domergan/drsstc/sources/universal_driver_pic_top.jpg

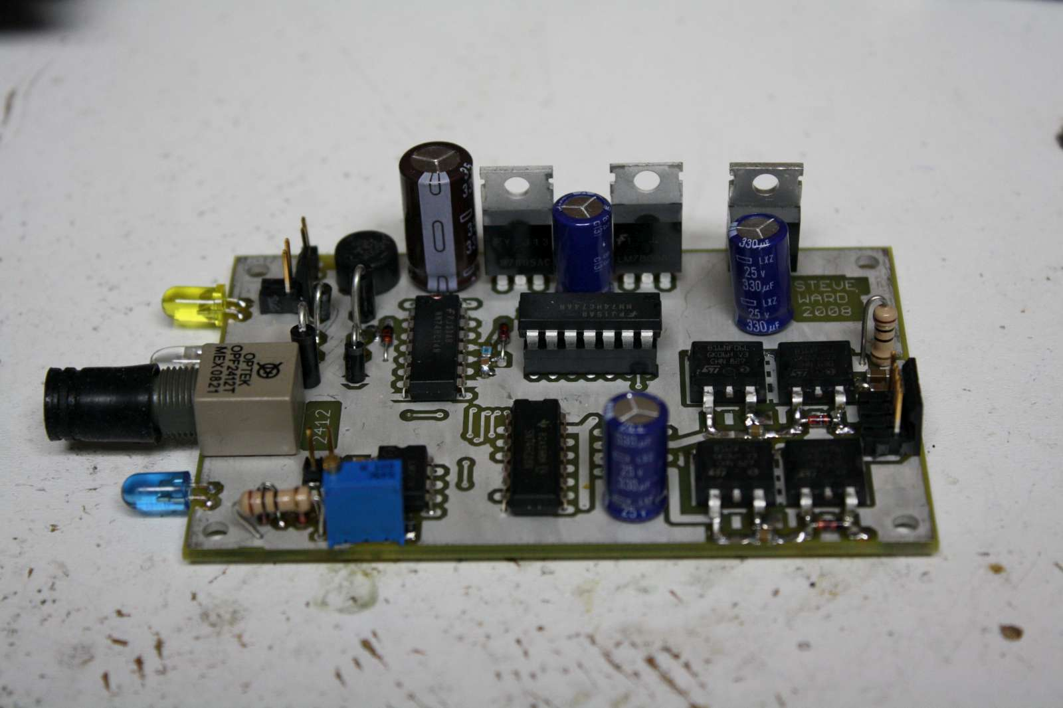
sources/universal_driver_pic_top.jpg
