domergan/drsstc/sources/universal_driver_pic_bottom.jpg

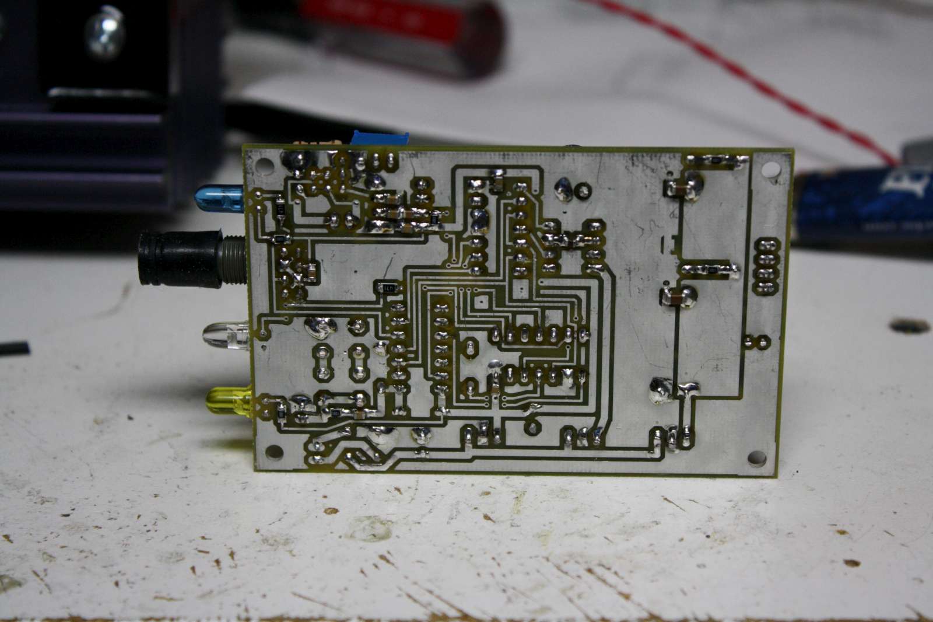
sources/universal_driver_pic_bottom.jpg
