domergan/drsstc/README.md

# Dual Resonance SSTC

My repo containing all my files and codes for my DRSSTC project. 

## Sources

- https://www.stevehv.4hv.org/DRSSTC.5.htm
- https://www.stevehv.4hv.org/new_driver.html
- https://www.f-legrand.fr/scidoc/docmml/sciphys/arduino/onduleur2/onduleur2.html
