domergan/drsstc/sources/DRSSTC-.5sch.JPG

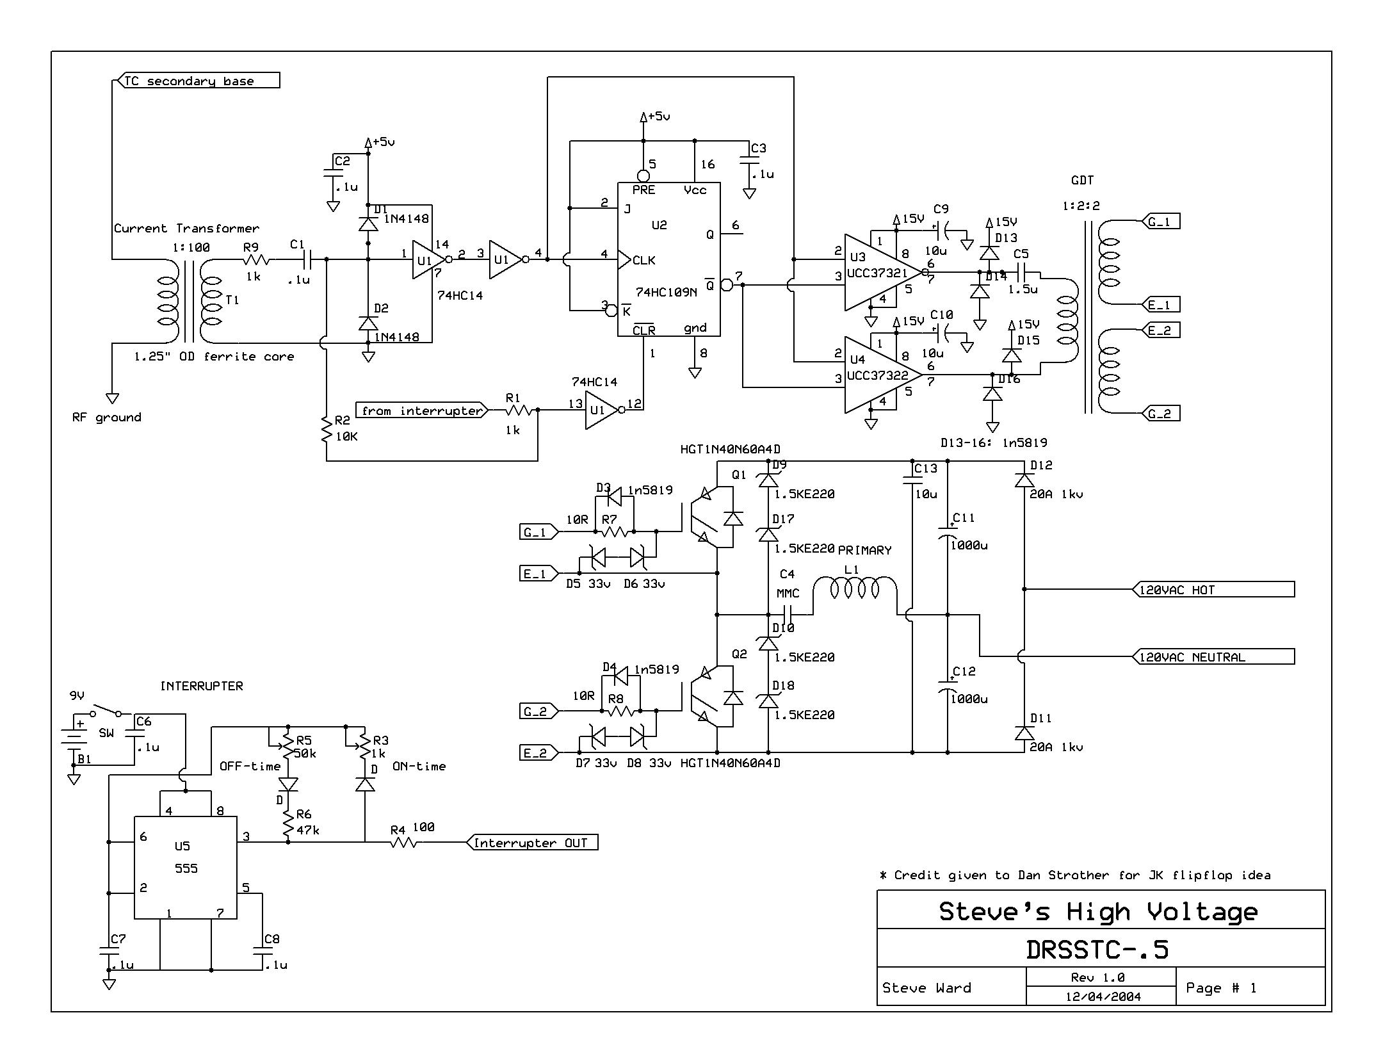
sources/DRSSTC-.5sch.JPG
