domergan/drsstc/kicad/BOM.ods

Part Description | Part number (OLD) | schematic ID (OLD) | Part Number (NEW) | Schematic ID (NEW) | Quantity | Comment | Supplier Link (LCSC, Digikey)
74HC14 Schmitt Trigger | MM74HC14N | IC1 | MM74HC14M | U1 | 1 |  | https://www.lcsc.com/product-detail/C900094.html?s_z=n_q_p_MM74HC14N
74HC74 D Flip-Flop | MM74HC74AN | IC3 | SN74HC74DR | U7 | 1 |  | https://www.lcsc.com/product-detail/C6762.html?s_z=n_q_t_74HC74
74HC08 AND Gate | SN74HC08N | IC2 | SN74HC08DR | U6 | 1 |  | https://www.lcsc.com/product-detail/C337768.html?s_z=n_q_t_74HC08
LM311 Differential Comparator | LM311N | IC4 | LM311MX/NOPB | U5 | 1 |  | https://www.lcsc.com/product-detail/C7939.html?s_z=n_q_t_LM311M
UCC27423 Gate Driver | UCC27423P | IC8 | UCC27523D | U2 | 1 |  | https://www.lcsc.com/product-detail/C206023.html?s_z=n_q_UCC27523
7805 Regulator | L7805ACV | IC7 | L7805ACV-DG | U8 | 1 |  | https://www.lcsc.com/product-detail/C472632.html?s_z=n_q_L7805ACV
7809 Regulator | L7809ACV | IC6 | L7809CV-DG | U3 | 1 |  | https://www.lcsc.com/product-detail/C3794.html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
7824 Regulator | L7824ACV | IC5 | L7824CV | U10 | 1 |  | https://www.lcsc.com/product-detail/C262910.html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
STB16NF06 nFET | STB16NF06L | Q1,Q2 | / | / | 2 | OBSOLETE
STB16PF06 pFET | STB16PF06L | Q3,Q4 | / | / | 2 | OBSOLETE
nFET-pFET Pair | / | / | FDS4559 | Q1, Q2 |  | REPLACEMENT | https://www.lcsc.com/product-detail/C97044.html?s_z=n_q_x_FDS4559
10uF 50V 1206 X7R | 81-GRM31CF51E106ZA01 | C11,C12,C13,C14 | CL31B106KBHNNNE | C3, C4, C7, C21 | 4 |  | https://www.lcsc.com/product-detail/C89632.html
1uF 50V 1206 X7R | 80-C0805C105Z4V | C8 | CL31B105KBHNNNE | C10, C11, C16, C17, C18 | 1 |  | https://www.lcsc.com/product-detail/C1848.html
100nF 50V 0805 X7R | VJ0805Y104KXAAT | C1,C2,C5,C7,C9,C10,C19,C20,C22 | CL21B104KBCNNNC | C1, C5, C20, C8, C9 | 9 |  | https://www.lcsc.com/product-detail/C1711.html
22nF 0805 | 80-C0805C223K1R | C3 | / | C6 | 1 | Kit
1nF 0805 | C0805C102K5RAC7411 | C4,C6 | / | C2, C19 | 2 | Kit
100uF 35V lytic 20 % | 647-UPJ1V101MPD | C15 | UES1V101MPM | C12 | 1 |  | https://www.lcsc.com/product-detail/C1668995.html
330uF 35V lytic 20 % | 661-ELXZ250ELL331MH1 | C16,C17,C18 | UKA1V331MPD1TD | C13, C14, C15 | 3 |  | https://www.lcsc.com/product-detail/C1585271.html
100V 2A bridge | 625-W01G-E4 | B1 | TB210S | D14 | 1 |  | https://www.lcsc.com/product-detail/C4749007.html
4.7V 5W zener | 1N5337B | D3,D4 | 1N5337BRLG | D18, D19 | 2 |  | https://www.lcsc.com/product-detail/C9705.html?s_z=n_q_1N5337B
1n5819 schottky | 1N5819 | D1,D2,D8,D9,D10,D11 | 1N5819 | D1, D4, D7, D8, D9, D10 | 6 |  | https://www.lcsc.com/product-detail/C110032.html?s_z=n_q_l_1N5819
1n4148 diode | 1N4148 | D5,D6,D7 | 1N4148TR | D5, D6, D12 | 3 |  | https://www.lcsc.com/product-detail/C84410.html?s_z=n_q_t_1N4148
10k trimpot | 72-T93YA-10K | R3 | / | RV1 | 1 | Kit
1k 0805 | 292-1.0K-RC | R1,R6,R7,R9,R10,R12 | / | R9, R3, R6, R7, R1, R11, R12 | 6 | Kit
475R 0805 | 260-475-RC | R8,R13 | / | R4, R13 | 2 | Kit
2k2 SMD (1k in the schematic…) | 292-2.2K-RC | R14 | / | / | 1
20k 0805 SMD | 292-20k-RC | R2 | / | R5 | 1 | Kit
10R 500mW 1 % | 660-CF1/2CT52R100J | R4,R11 | CRM1206-FX-10R0ELF | R2, R10 | 2 |  | https://www.lcsc.com/product-detail/C840609.html
Green LED | ? | D16 | TLHG4200 | D16, D17 | 1 |  | https://www.lcsc.com/product-detail/C6333075.html?s_z=n_q_t_LED
blue LED | 638-264-7SUBCC4704 | D18 | / | / | 1
red LED (Not used) | ? | D13 | / | D11 | 1 | Kit
Fiber optic Rx (Not used) | OPF2412T | XR1 | / | / | 1
Screw Terminal | 22-28-0360 | JP1, JP2, JP3, JP4,JP5,JP6 | / | JP1, JP2, JP3, JP4,JP5,JP6 | 1 | Kit
NOT ON BOARD BUT MAY BE REQUIRED FOR CIRCUIT
18V 1A xfrmr | LP433 | powers board |  |  | 3,1
ferrite toroids ** | G6683 | used for current sense |  |  | 0,99
Stand-offs 4-40 x 0.5" | ? | mechanical board support
GDT toroid 5000 mat. | 32-29-22-0002 | used for LARGE GDT | 5977001021 | / | 1 |  | https://www.digikey.be/en/products/detail/fair-rite-products-corp/5977001021/15930548
aluminum project box | 270-238 |  |  |  | 1
PARTS LIST FOR DRSSTC CONTROLLER REVISIONS 1.2/1.3 ONLY!
**A similar sized 5000 material toroid from TSC ferrite would work fine
