domergan/drsstc/3d_parts/STEP/assembly_reference.step

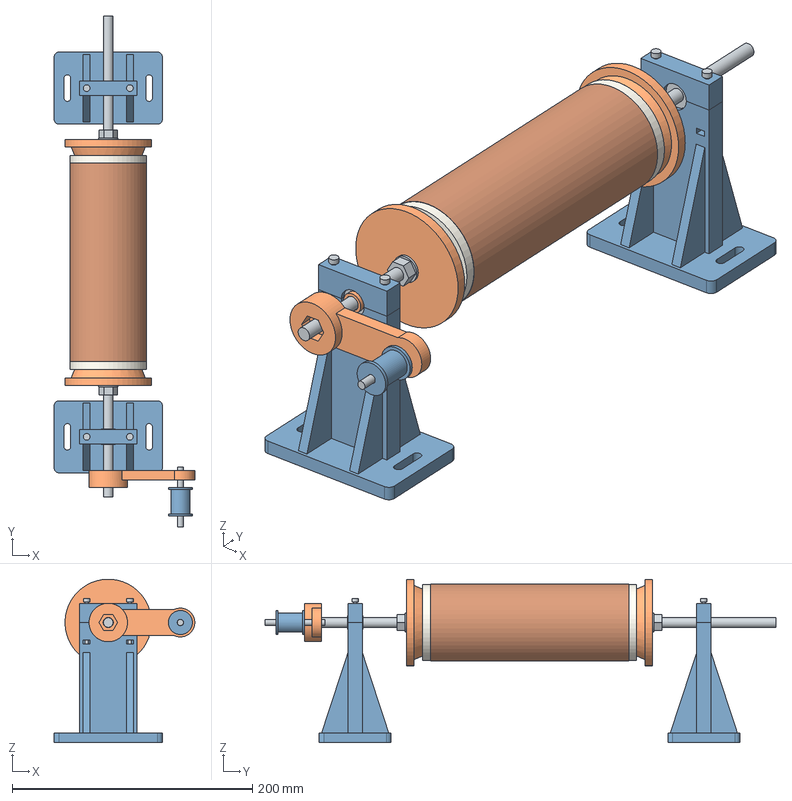
[picture p4: CAD file, 2026-09-12]
3d_parts/STEP/assembly_reference.step
117.0 x 425.0 x 136.0 mm
stand_1
cap_1
bearing_608_1
cap_screw_0_0
cap_screw_0_1
stand_2
cap_2
bearing_608_2
cap_screw_1_0
cap_screw_1_1
M8_threaded_rod_400mm
chuck_1
chuck_captive_nut_0
chuck_back_nut_0
chuck_washer_0
chuck_2
chuck_captive_nut_1
chuck_back_nut_1
chuck_washer_1
PVC_form_illustrative_ID56mm
wire_envelope_reference_only
hand_crank
rotating_grip
M5_handle_bolt
locating_bearing_spacer_0
locating_bearing_spacer_1
