domergan/drsstc/3d_parts/STEP/fit_coupon.step

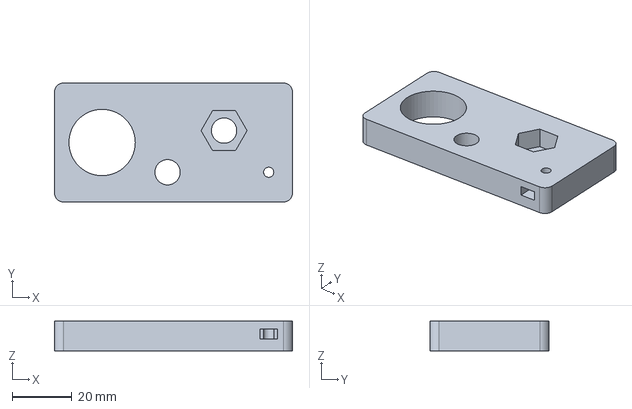
[picture p5: CAD file, 2026-09-12]
3d_parts/STEP/fit_coupon.step
80.0 x 40.0 x 10.0 mm
