domergan/drsstc/3d_parts/winder_parts.3mf

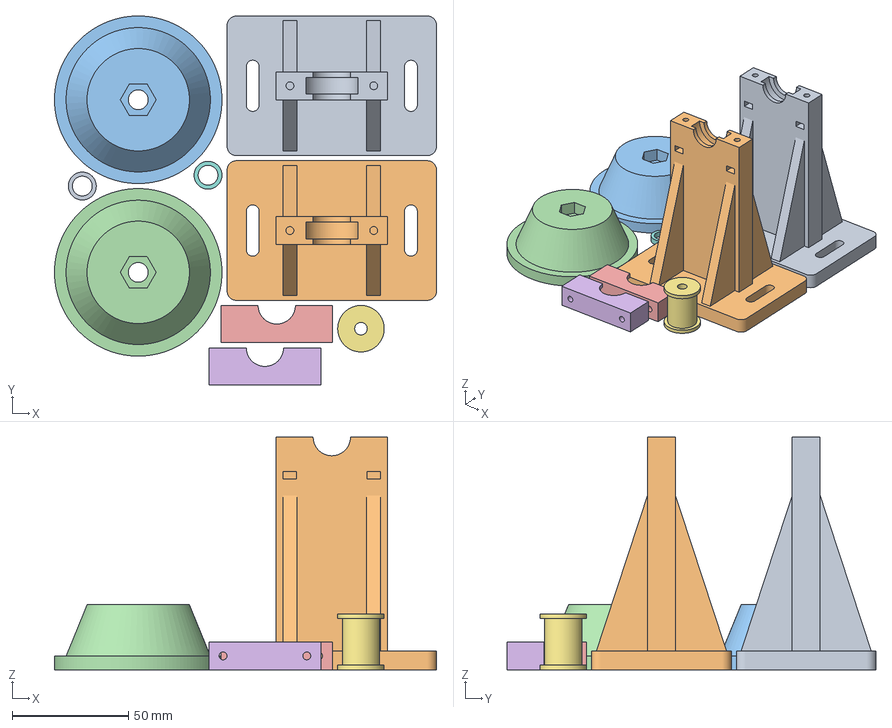
[picture p6: CAD file, 2026-09-12]
3d_parts/winder_parts.3mf
164.2 x 158.6 x 100.0 mm
stand_1
stand_2
centering_chuck_3
centering_chuck_4
bearing_cap_6
bearing_cap_7
rotating_grip_8
bearing_spacer_9
bearing_spacer_10
