domergan/drsstc/3d_parts/STEP/centering_chuck.step

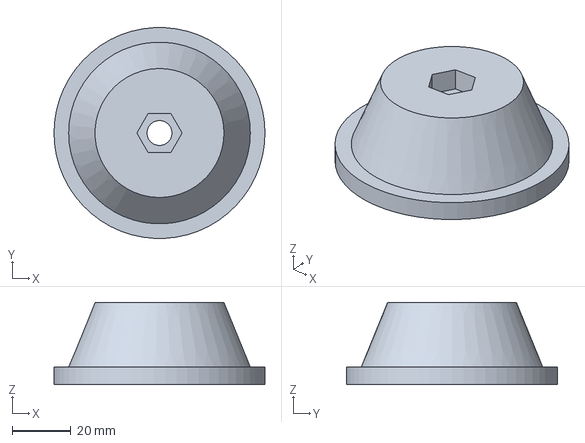
[picture p7: CAD file, 2026-09-12]
3d_parts/STEP/centering_chuck.step
72.0 x 71.9 x 28.0 mm
