domergan/drsstc/3d_parts/STEP/bearing_spacer.step

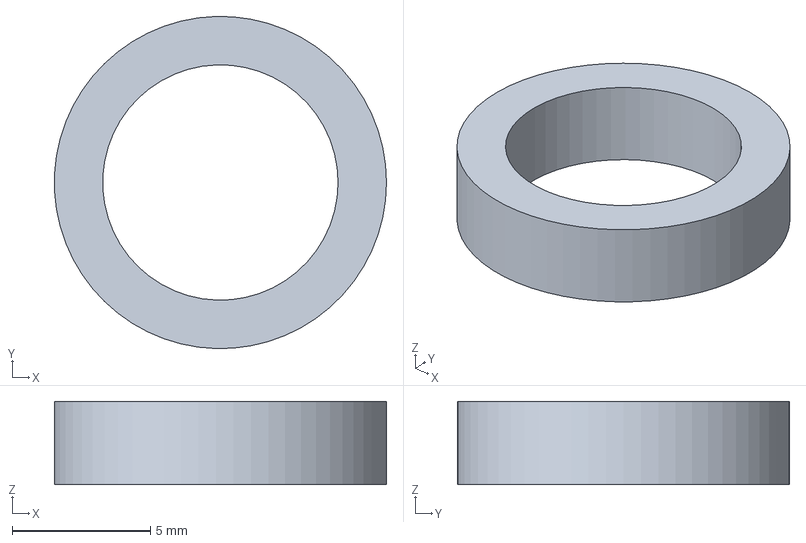
[picture p8: CAD file, 2026-09-12]
3d_parts/STEP/bearing_spacer.step
12.0 x 12.0 x 3.00 mm
