domergan/drsstc/3d_parts/STEP/hand_crank.step

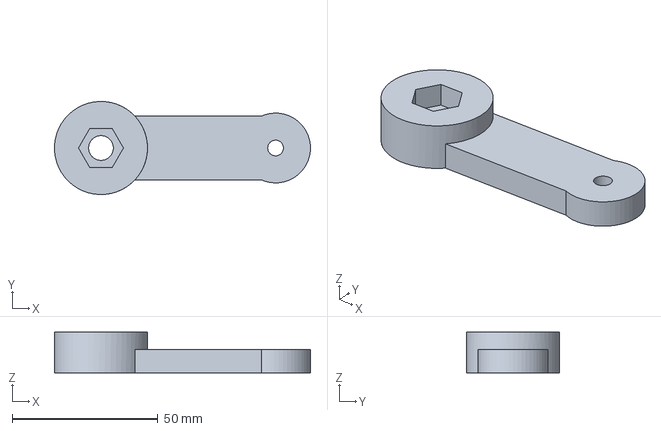
[picture p9: CAD file, 2026-09-12]
3d_parts/STEP/hand_crank.step
88.0 x 32.0 x 14.0 mm
