domergan/drsstc/3d_parts/STEP/stand.step

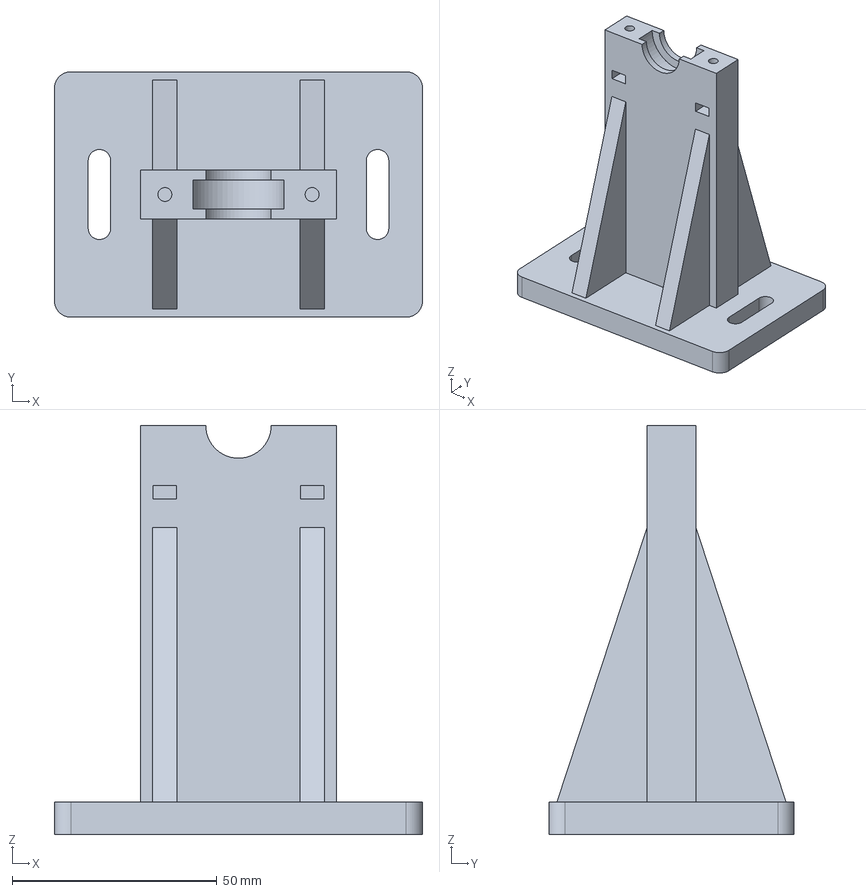
[picture p10: CAD file, 2026-09-12]
3d_parts/STEP/stand.step
90.0 x 60.0 x 100.0 mm
