domergan/drsstc/3d_parts/STEP/bearing_cap.step

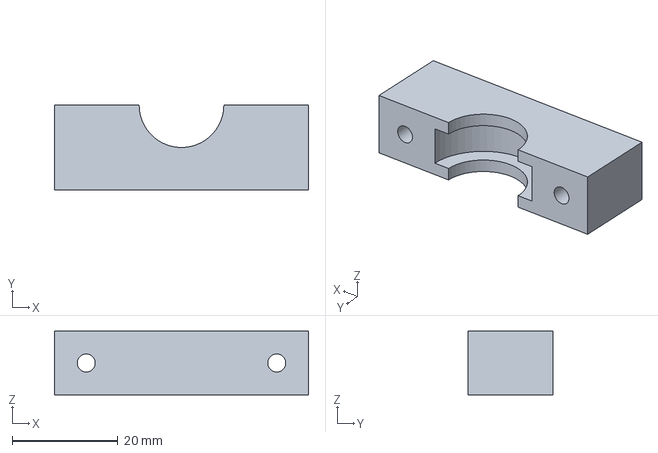
[picture p11: CAD file, 2026-09-12]
3d_parts/STEP/bearing_cap.step
48.0 x 16.0 x 12.0 mm
