domergan/drsstc/3d_parts/STEP/rotating_grip.step

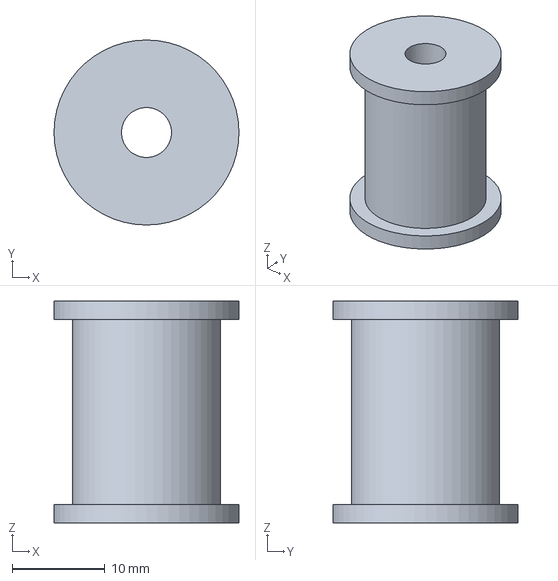
[picture p12: CAD file, 2026-09-12]
3d_parts/STEP/rotating_grip.step
20.0 x 20.0 x 24.0 mm
