domergan/drsstc/(list of files, cad)

Other CAD files:
3d_parts/STL/bearing_cap.stl
3d_parts/STL/bearing_spacer.stl
3d_parts/STL/centering_chuck.stl
3d_parts/STL/fit_coupon.stl
3d_parts/STL/hand_crank.stl
3d_parts/STL/rotating_grip.stl
3d_parts/STL/stand.stl
