domergan/drsstc/sources/DRSSTC_pndriver1_3_bcomp.pdf

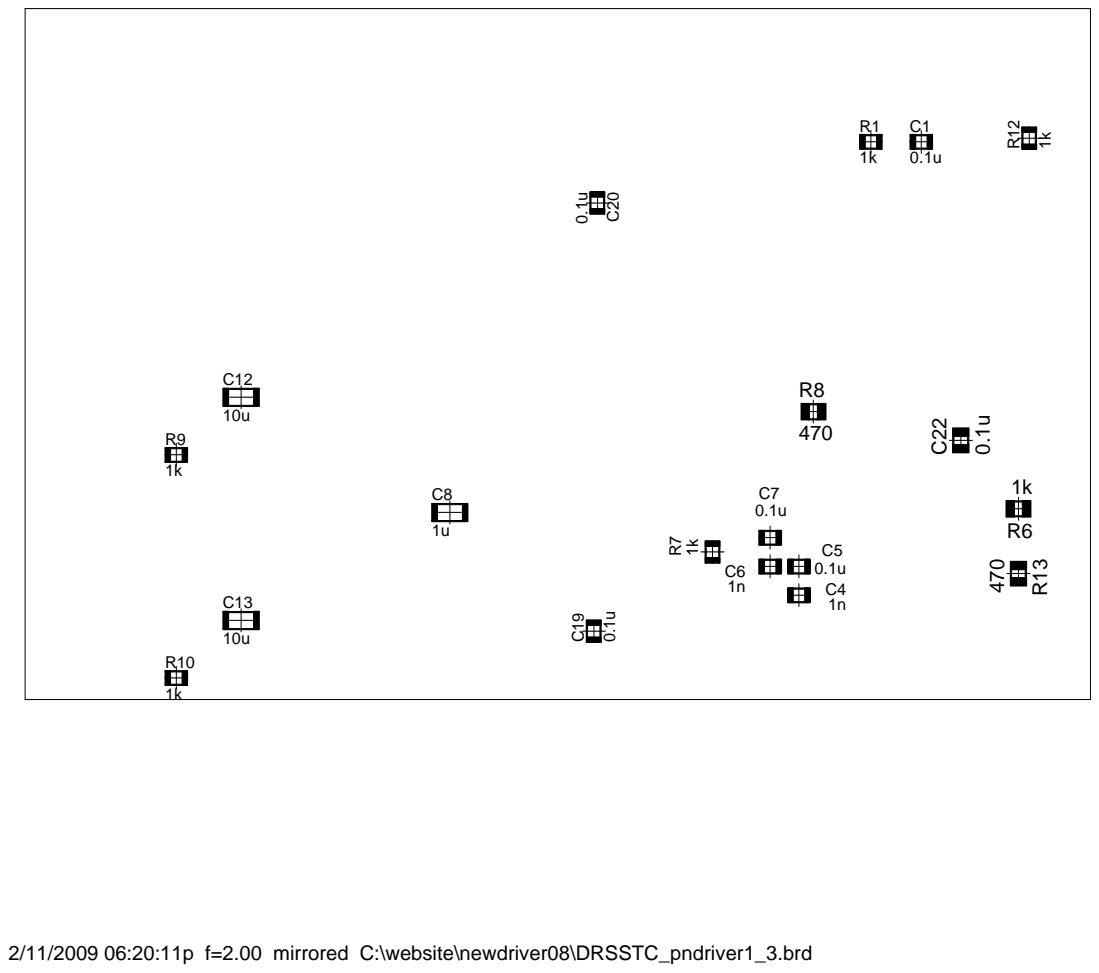
[picture p13: page 1]
