domergan/drsstc/sources/DRSSTC_pndriver1_3_tcomp.pdf

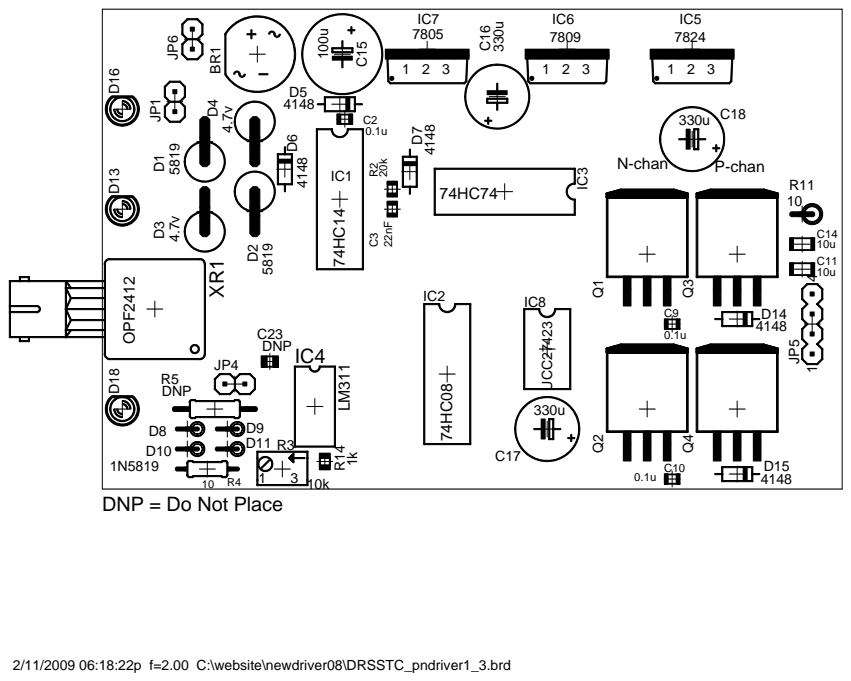
[picture p14: page 1]
