domergan/drsstc/kicad/controller/controller.kicad_pcb

## KiCad design kicad/controller/controller.kicad_pcb (2026-09-12)

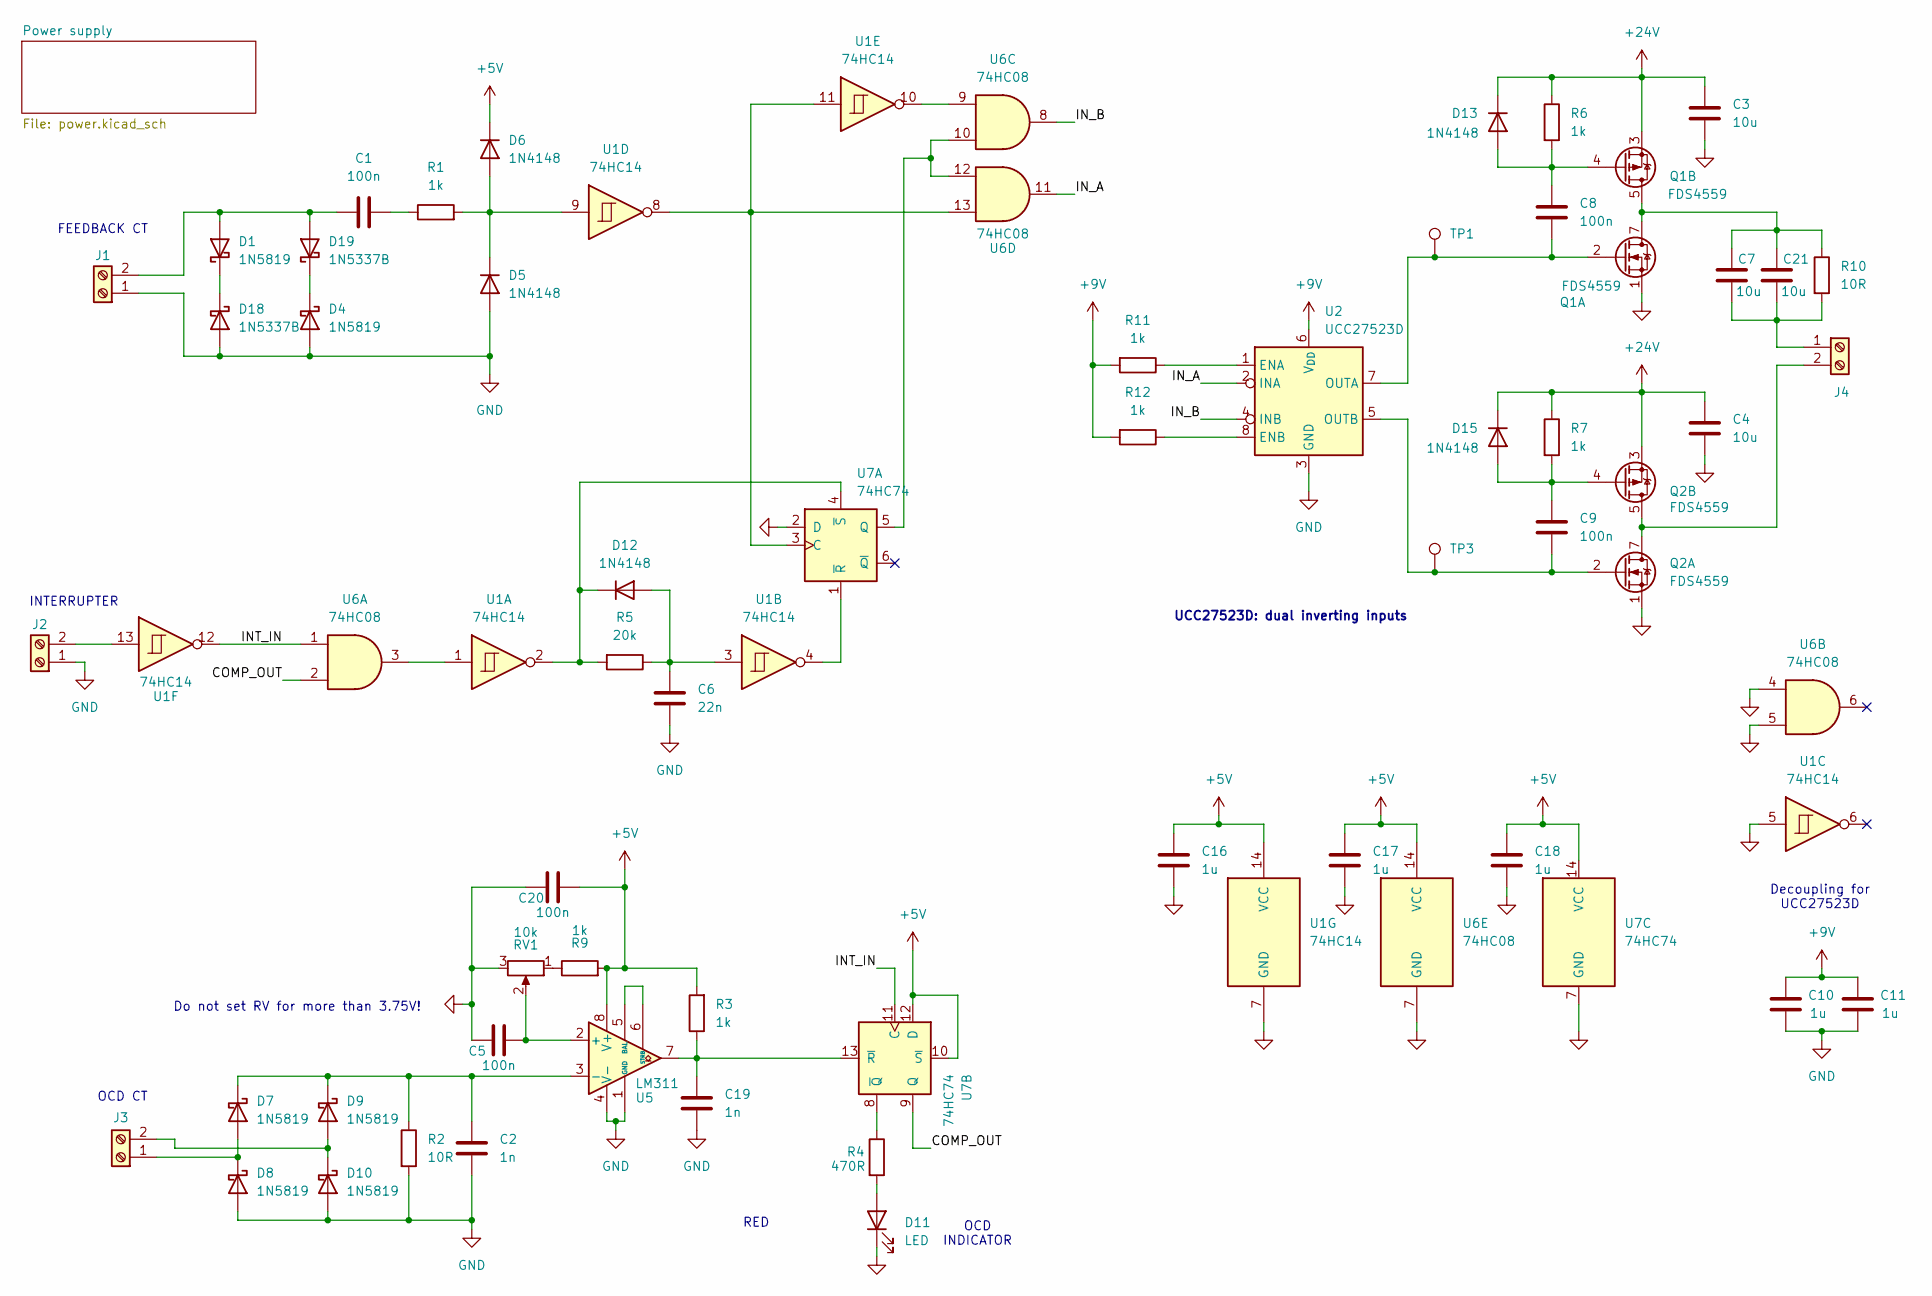
[picture p16: schematic controller.kicad_sch]

Parts:
C1, C5, C8, C9, C20: 100n; C_0805_2012Metric_Pad1.18x1.45mm_HandSolder
C2, C19: 1n; C_0805_2012Metric_Pad1.18x1.45mm_HandSolder
C3, C4, C7, C21: 10u; C_1206_3216Metric_Pad1.33x1.80mm_HandSolder
C6: 22n; C_0805_2012Metric_Pad1.18x1.45mm_HandSolder
C10, C11, C17, C18: 1u; C_1206_3216Metric_Pad1.33x1.80mm_HandSolder
C16: 1u; C_1206_3216Metric_Pad1.33x1.80mm_HandSolder; Voltage 10V
D1, D4, D7, D8, D9, D10: 1N5819; D_DO-41_SOD81_P2.54mm_Vertical_CathodeUp
D5, D6, D12, D13, D15: 1N4148; D_DO-35_SOD27_P2.54mm_Vertical_CathodeUp
D11: LED; LED_D3.0mm
D18, D19: 1N5337B; D_DO-201AD_P12.70mm_Horizontal
J1, J2, J3, J4: Screw_Terminal_01x02; TerminalBlock_MaiXu_MX126-5.0-02P_1x02_P5.00mm
Q1, Q2: FDS4559; SOIC-8_3.9x4.9mm_P1.27mm
R1, R3, R6, R7, R9, R11, R12: 1k; R_0805_2012Metric_Pad1.20x1.40mm_HandSolder
R2, R10: 10R; R_1206_3216Metric_Pad1.30x1.75mm_HandSolder
R4: 470R; R_0805_2012Metric_Pad1.20x1.40mm_HandSolder
R5: 20k; R_0805_2012Metric_Pad1.20x1.40mm_HandSolder
RV1: 10k; Potentiometer_Bourns_3266Y_Vertical
TP1, TP3: TestPoint; TestPoint_THTPad_D2.0mm_Drill1.0mm
U1: 74HC14; SOIC-14_3.9x8.7mm_P1.27mm
U2: UCC27523D; SOIC-8_3.9x4.9mm_P1.27mm
U5: LM311; SOIC-8_3.9x4.9mm_P1.27mm
U6: 74HC08; SOIC-14_3.9x8.7mm_P1.27mm
U7: 74HC74; SOIC-14_3.9x8.7mm_P1.27mm

Connections:
+5V: C16.2, C17.2, C18.2, C20.1, D6.1 (K), R3.2, R9.2, U1.14 (VCC), U5.8 (V+), U6.14 (VCC), U7.10 (~S), U7.12 (D), U7.14 (VCC); also elsewhere on the board
+9V: C10.2, C11.2, R11.2, R12.2, U2.6 (V_{DD}); also elsewhere on the board
+24V: C3.2, C4.2, D13.1 (K), D15.1 (K), Q1.3 (S2), Q2.3 (S2), R6.1, R7.1; also elsewhere on the board
/COMP_OUT: U6.2, U7.9 (Q)
/INT_IN: U1.12, U6.1, U7.11 (C)
/IN_A: U2.2 (INA), U6.11
/IN_B: U2.4 (INB), U6.8
GND: C2.1, C3.1, C4.1, C5.2, C6.2, C10.1, C11.1, C16.1, C17.1, C18.1, C19.2, C20.2, D4.2 (A), D5.2 (A), D8.2 (A), D10.2 (A), D11.1 (K), D18.2 (A), J1.1, J2.1, Q1.1 (S1), Q2.1 (S1), R2.2, RV1.3, U1.5, U1.7 (GND), U2.3 (GND), U5.1 (GND), U5.4 (V-), U6.4, U6.5, U6.7 (GND), U7.2 (D), U7.7 (GND); also elsewhere on the board
unnamed: C1.2, R1.1
unnamed: C7.2, C21.2, Q1.5 (D2), Q1.6 (D2), Q1.7 (D1), Q1.8 (D1), R10.1
unnamed: C1.1, D1.2 (A), D19.2 (A), J1.2
unnamed: D1.1 (K), D18.1 (K)
unnamed: D5.1 (K), D6.2 (A), R1.2, U1.9
unnamed: D7.2 (A), D8.1 (K), J3.1
unnamed: C2.2, D7.1 (K), D9.1 (K), R2.1, U5.3 (-)
unnamed: D9.2 (A), D10.1 (K), J3.2
unnamed: D11.2 (A), R4.2
unnamed: C6.1, D12.2 (A), R5.1, U1.3
unnamed: D12.1 (K), R5.2, U1.2, U7.4 (~S)
unnamed: C8.1, D13.2 (A), Q1.4 (G2), R6.2
unnamed: C9.1, D15.2 (A), Q2.4 (G2), R7.2
unnamed: D4.1 (K), D19.1 (K)
unnamed: J2.2, U1.13
unnamed: C7.1, C21.1, J4.1, R10.2
unnamed: J4.2, Q2.5 (D2), Q2.6 (D2), Q2.7 (D1), Q2.8 (D1)
unnamed: C8.2, Q1.2 (G1), TP1.1 (1_1), U2.7 (OUTA)
unnamed: C9.2, Q2.2 (G1), TP3.1 (1_1), U2.5 (OUTB)
unnamed: R9.1, RV1.1
unnamed: U1.1, U6.3
unnamed: U1.10, U6.9
unnamed: R11.1, U2.1 (ENA)
unnamed: R12.1, U2.8 (ENB)
unnamed: C5.1, RV1.2, U5.2 (+)
unnamed: U5.5 (BAL), U5.6 (STRB)
unnamed: U1.8, U1.11, U6.13, U7.3 (C)
unnamed: U6.10, U6.12, U7.5 (Q)
unnamed: U1.4, U7.1 (~R)
unnamed: R4.1, U7.8 (~Q)
unnamed: C19.1, R3.1, U5.7, U7.13 (~R)

Notes on the sheet:
OCD INDICATOR
Decoupling for UCC27523D
INTERRUPTER
UCC27523D: dual inverting inputs
FEEDBACK CT
OCD CT
Do not set RV for more than 3.75V!
RED

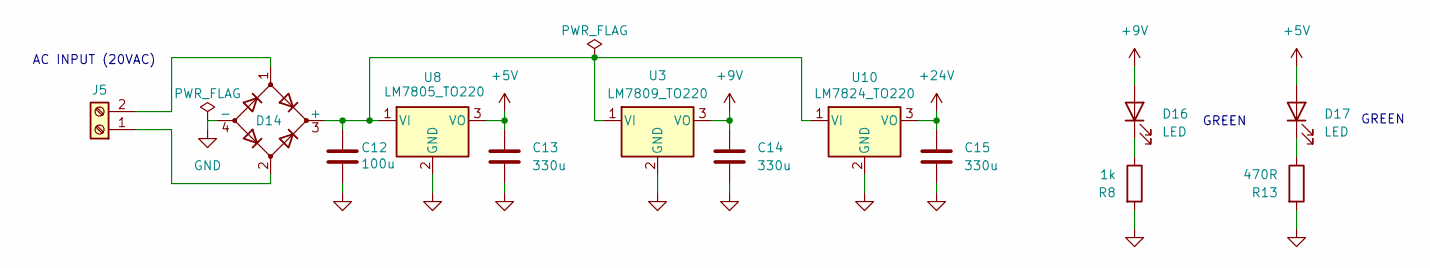
[picture p17: schematic power.kicad_sch]

Parts:
C12: 100u; CP_Radial_D10.0mm_P5.00mm
C13, C14, C15: 330u; CP_Radial_D10.0mm_P5.00mm
D14: TB210S; TB210S_ABS
D16, D17: LED; LED_D3.0mm
J5: Screw_Terminal_01x02; TerminalBlock_MaiXu_MX126-5.0-02P_1x02_P5.00mm
R8: 1k; R_0805_2012Metric_Pad1.20x1.40mm_HandSolder
R13: 470R; R_0805_2012Metric_Pad1.20x1.40mm_HandSolder
U3: LM7809_TO220; TO-220-3_Vertical
U8: LM7805_TO220; TO-220-3_Vertical
U10: LM7824_TO220; TO-220-3_Vertical

Connections:
+5V: C13.1, D17.2 (A), U8.3 (VO); also elsewhere on the board
+9V: C14.1, D16.2 (A), U3.3 (VO); also elsewhere on the board
+24V: C15.1, U10.3 (VO); also elsewhere on the board
GND: C12.2, C13.2, C14.2, C15.2, D14.4 (-), R8.2, R13.2, U3.2 (GND), U8.2 (GND), U10.2 (GND); also elsewhere on the board
unnamed: C12.1, D14.3 (+), U3.1 (VI), U8.1 (VI), U10.1 (VI)
unnamed: D16.1 (K), R8.1
unnamed: D17.1 (K), R13.1
unnamed: D14.2, J5.1
unnamed: D14.1, J5.2

Notes on the sheet:
AC INPUT (20VAC)
GREEN

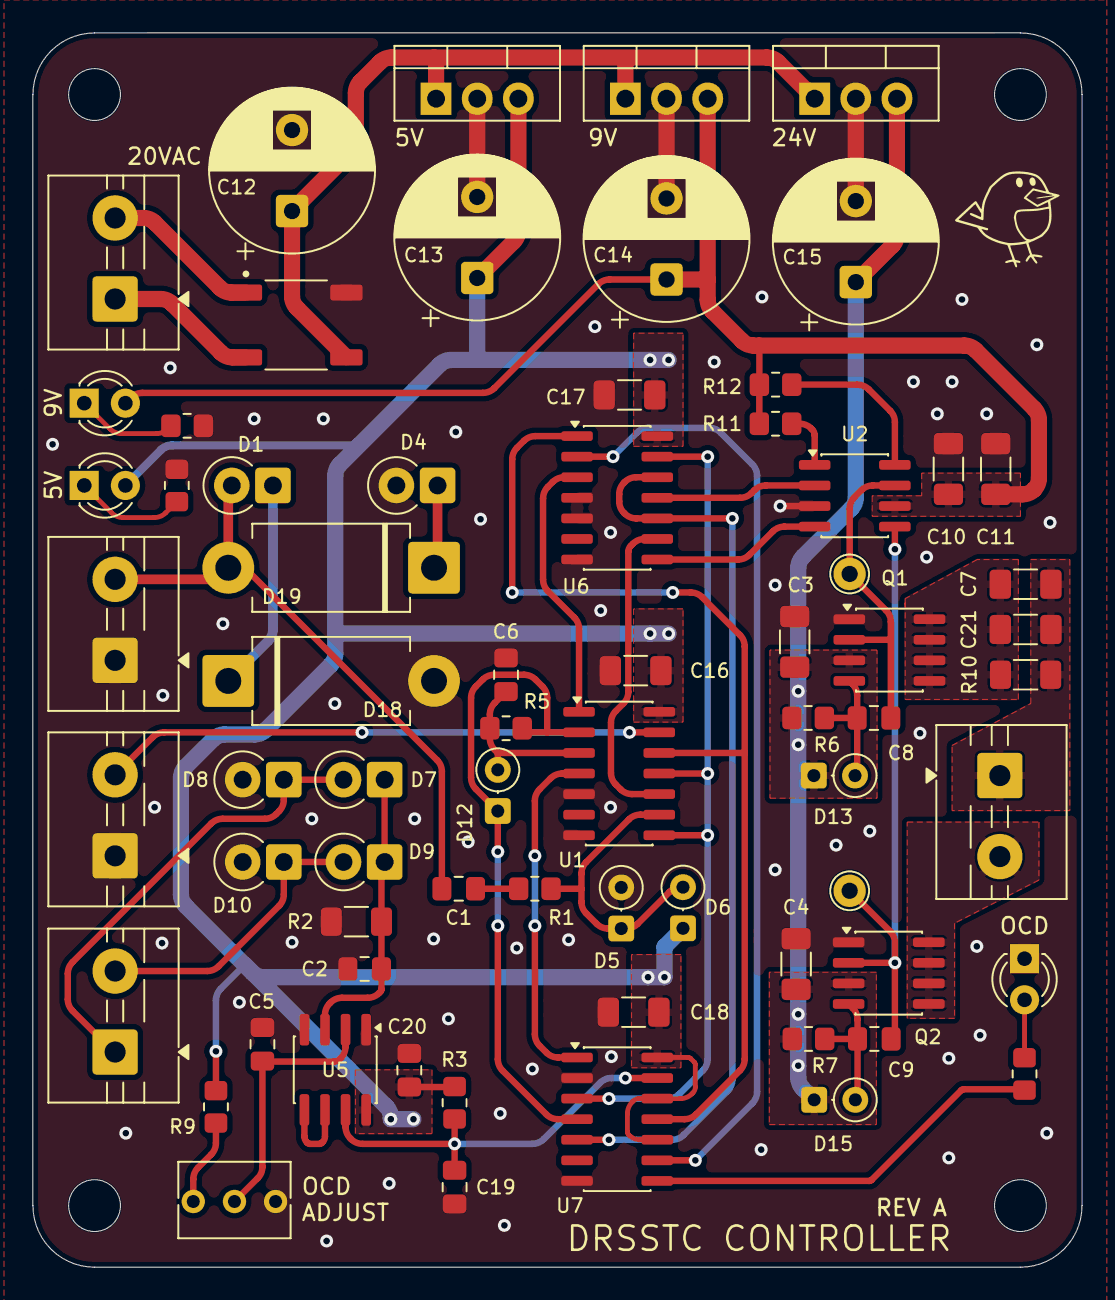
[picture p18: board controller.kicad_pcb from above]

Board: 2 copper layers, 64.8 x 76.2 mm, 73 parts (0 on the bottom side), 44 nets.

Other parts of the board:
H1, H2, H3, H4: M3 / 3.2mm NPTH; MountingHole_3.2mm_M3
