domergan/drsstc/3d_parts/assembly_pr.png

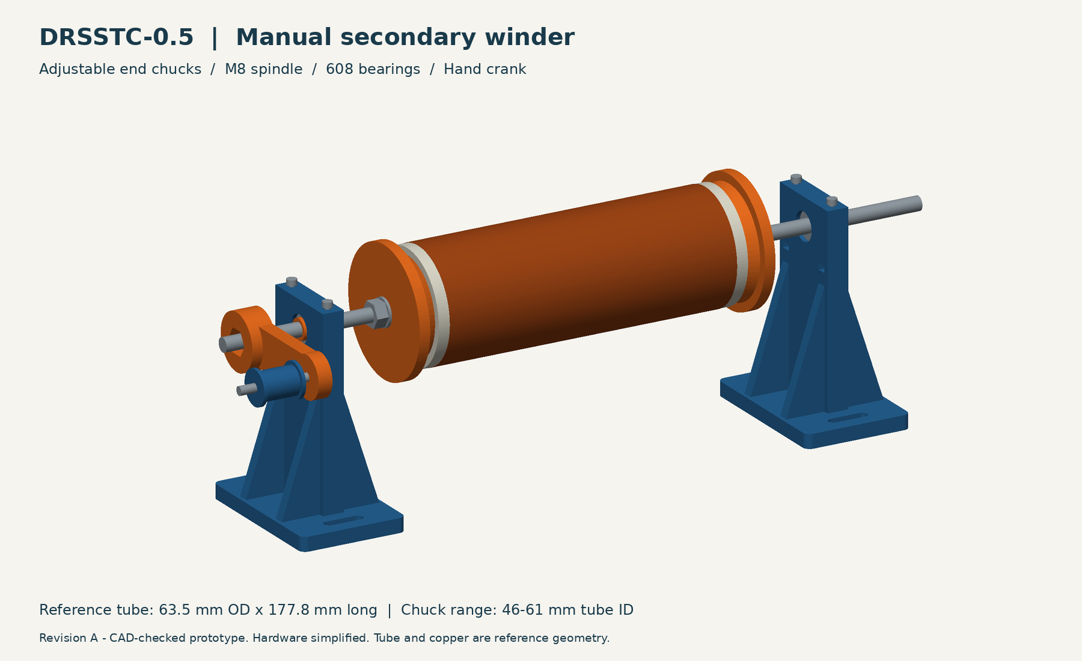
3d_parts/assembly_pr.png
